crazynucfan/thread-clapclap/firmware/ThreadClapClap/ThreadClapClap.ino

#include <Arduino.h>
#include <Matter.h>
#include <sdkconfig.h>

#if !defined(CONFIG_IDF_TARGET_ESP32C6)
#error "Select XIAO_ESP32C6. This example targets the ESP32-C6 native Thread radio."
#endif
#if !CONFIG_ENABLE_MATTER_OVER_THREAD || !CONFIG_ENABLE_CHIPOBLE
#error "This example requires Matter over Thread with BLE commissioning."
#endif
#if !CONFIG_OPENTHREAD_FTD
#error "A Full Thread Device build is required for Thread router eligibility."
#endif

#include <esp_openthread.h>
#include <esp_openthread_lock.h>
#include <openthread/thread.h>
#include <openthread/thread_ftd.h>
#include <openthread/link.h>
#include <platform/CHIPDeviceLayer.h>

#include "Config.h"
#include "AnalogAudio.h"
#include "AudioCapture.h"
#include "WaveCapture.h"
#include <esp_heap_caps.h>
#include "CnnDetector.h"

MatterGenericSwitch clapSwitch;
ClapDetector detector(config::detector);
AnalogAudio audio;
AudioAnalyzer analyzer;
ImpulseClapDetector audioDetector(config::audioDetector);
#if defined(CLAP_USE_CNN) && CLAP_USE_CNN
CnnDetector cnnDetector;
#endif
uint32_t lastAudioOverflow = 0;
uint32_t lastAudioStatus = 0;
uint32_t analyzedFrames = 0;
uint32_t acceptedAudioClaps = 0;
uint32_t rejectedAudioSounds = 0;
uint32_t maxAnalysisUs = 0;
uint32_t captureSession = 0, captureRemaining = 0, captureSequence = 0, captureDropped = 0, captureClicks = 0;
bool capturePending = false;
bool diagnosticsEnabled = config::diagnosticsOnBoot;
uint32_t waveRemaining = 0, waveSession = 0, waveSequence = 0, waveDropped = 0;
WaveCaptureFrame wavePacket;
unsigned waveFill = 0;

static void abortCapture(const char *reason) {
#if defined(CLAP_USE_CNN) && CLAP_USE_CNN
  cnnDetector.reset();
#endif
  if (captureRemaining) Serial.printf("CAPTURE_ABORT %lu %s\n", static_cast<unsigned long>(captureSession), reason);
  capturePending = false;
  captureRemaining = 0;
  if (waveRemaining) {
    Serial.printf("WAVE_ABORT %lu %s\n", static_cast<unsigned long>(waveSession), reason);
    analyzer.reset();
    audioDetector.reset(0);
  }
  waveRemaining = 0;
  waveFill = 0;
}

static void captureWave(const uint16_t *samples, uint32_t count) {
  for (uint32_t i = 0; i < count && waveRemaining; ++i) {
    wavePacket.samples[waveFill++] = samples[i];
    if (waveFill != 64) continue;
    if (audio.overflows() != lastAudioOverflow) {
      abortCapture("dma_overflow");
      return;
    }
    wavePacket.session = waveSession;
    wavePacket.sequence = waveSequence;
    wavePacket.firstSample = waveSequence++ * 64;
    wavePacket.checksum = captureCrc32(&wavePacket, offsetof(WaveCaptureFrame, checksum));
    if (Serial.availableForWrite() < static_cast<int>(sizeof(wavePacket))
        || Serial.write(reinterpret_cast<const uint8_t *>(&wavePacket), sizeof(wavePacket)) != sizeof(wavePacket)) ++waveDropped;
    waveFill = 0;
    if (--waveRemaining == 0) {
      Serial.printf("WAVE_END %lu %lu %lu\n", static_cast<unsigned long>(waveSession),
                    static_cast<unsigned long>(waveSequence), static_cast<unsigned long>(waveDropped));
    }
  }
}

static void handleSerialCommands() {
  static char line[64];
  static size_t length = 0;
  static bool tooLong = false;
  for (unsigned budget = 0; budget < 64 && Serial.available(); ++budget) {
    const char c = static_cast<char>(Serial.read());
    if (c == '\r') continue;
    if (c != '\n') {
      if (length < sizeof(line) - 1) line[length++] = c;
      else tooLong = true;
      continue;
    }
    line[length] = 0;
    unsigned long session = 0, seconds = 0;
    char extra = 0;
    if (!tooLong && strcmp(line, "LOG ON") == 0) {
      diagnosticsEnabled = true;
      Serial.println("LOG ON: diagnostics enabled until reboot.");
    } else if (!tooLong && strcmp(line, "LOG OFF") == 0) {
      diagnosticsEnabled = false;
      Serial.println("LOG OFF: diagnostics disabled; detection continues.");
    } else if (!tooLong && strcmp(line, "MEMORY") == 0) {
      Serial.printf("Memory: free_8bit=%u largest_8bit=%u minimum_free_8bit=%u\n",
                    static_cast<unsigned>(heap_caps_get_free_size(MALLOC_CAP_8BIT)),
                    static_cast<unsigned>(heap_caps_get_largest_free_block(MALLOC_CAP_8BIT)),
                    static_cast<unsigned>(heap_caps_get_minimum_free_size(MALLOC_CAP_8BIT)));
#if defined(CLAP_USE_CNN) && CLAP_USE_CNN
    } else if (!tooLong && strcmp(line, "CNN STATUS") == 0) {
      cnnDetector.status(audio.overflows(),maxAnalysisUs);
#endif
    } else if (!tooLong && (strcmp(line, "CAPTURE_STOP") == 0 || strcmp(line, "WAVE_STOP") == 0)) {
      abortCapture("stopped");
      audioDetector.reset(analyzer.timeMs());
    } else if (!tooLong && sscanf(line, "WAVE_CAPTURE %lu %lu %c", &session, &seconds, &extra) == 2
               && session && seconds >= 4 && seconds <= 600 && config::useAnalogAudio) {
      abortCapture("replaced");
      waveSession = static_cast<uint32_t>(session);
      waveRemaining = static_cast<uint32_t>(seconds * 250);
      waveSequence = waveDropped = waveFill = 0;
      audioDetector.reset(analyzer.timeMs());
      Serial.printf("WAVE_BEGIN %lu %lu 16000 %lu\n", static_cast<unsigned long>(waveSession),
                    static_cast<unsigned long>(waveRemaining), static_cast<unsigned long>(CLAP_DETECTOR_BUILD_ID));
    } else if (!tooLong && sscanf(line, "CAPTURE %lu %lu %c", &session, &seconds, &extra) == 2
               && session && seconds >= 4 && seconds <= 600 && config::useAnalogAudio) {
      abortCapture("replaced");
      captureSession = static_cast<uint32_t>(session);
      captureRemaining = static_cast<uint32_t>(seconds * 125);
      captureSequence = captureDropped = captureClicks = 0;
      capturePending = true;
    } else if (length) Serial.println("CAPTURE_ERROR expected LOG ON/OFF, MEMORY, CAPTURE/WAVE_CAPTURE <id> <4..600 seconds> or CAPTURE_STOP/WAVE_STOP");
    length = 0; tooLong = false;
  }
}

// Capture both edges: even very short LOW pulses reach the detector. No logging
// or Matter calls in the ISR. Drop the whole partial gesture on queue overflow.
struct SoundEdge {
  uint32_t ms;
  bool active;
};
constexpr uint16_t edgeCapacity = 128;
volatile SoundEdge edges[edgeCapacity];
volatile uint16_t edgeHead = 0;
volatile uint16_t edgeTail = 0;
volatile bool edgeOverflow = false;
portMUX_TYPE edgeMux = portMUX_INITIALIZER_UNLOCKED;

void ARDUINO_ISR_ATTR captureSoundEdge() {
  portENTER_CRITICAL_ISR(&edgeMux);
  const uint16_t next = (edgeHead + 1) % edgeCapacity;
  if (next == edgeTail) {
    edgeOverflow = true;
  } else {
    edges[edgeHead].ms = millis();
    edges[edgeHead].active = digitalRead(config::soundPin) == LOW;
    edgeHead = next;
  }
  portEXIT_CRITICAL_ISR(&edgeMux);
}

bool routerConfigured = false;
bool resetHeld = false;
bool resetRequested = false;
uint32_t resetStarted = 0;
uint32_t detectionStarted = 0;
uint32_t lastStatus = 0;
bool lastReady = false;
uint32_t droppedBatches = 0;

static void fatal(const char *message) {
  Serial.println(message);
  while (true) {
    delay(1000);
  }
}

static const char *roleName(otDeviceRole role) {
  switch (role) {
    case OT_DEVICE_ROLE_DISABLED: return "disabled";
    case OT_DEVICE_ROLE_DETACHED: return "detached";
    case OT_DEVICE_ROLE_CHILD: return "child";
    case OT_DEVICE_ROLE_ROUTER: return "router";
    case OT_DEVICE_ROLE_LEADER: return "leader";
    default: return "unknown";
  }
}

static void updateThreadStatus() {
  // Matter owns OpenThread initialization. Do not start a second OT stack,
  // create a dataset, or force a router role: join the phone's existing network.
  if (!esp_openthread_lock_acquire(pdMS_TO_TICKS(20))) {
    return;
  }
  otInstance *instance = esp_openthread_get_instance();
  if (instance == nullptr) {
    esp_openthread_lock_release();
    return;
  }
  otError error = OT_ERROR_NONE;
  if (!routerConfigured) {
    otLinkModeConfig mode = otThreadGetLinkMode(instance);
    mode.mRxOnWhenIdle = true;
    mode.mDeviceType = true;
    mode.mNetworkData = true;
    error = otThreadSetLinkMode(instance, mode);
    if (error == OT_ERROR_NONE) {
      error = otThreadSetRouterEligible(instance, true);
    }
    routerConfigured = error == OT_ERROR_NONE;
  }
  if (!diagnosticsEnabled) {
    esp_openthread_lock_release();
    return;
  }
  const otDeviceRole role = otThreadGetDeviceRole(instance);
  const bool eligible = otThreadIsRouterEligible(instance);
  otNeighborInfoIterator iterator = OT_NEIGHBOR_INFO_ITERATOR_INIT;
  otNeighborInfo neighbor;
  unsigned neighbors = 0;
  int weakestRssi = 0;
  unsigned minQuality = 3;
  while (otThreadGetNextNeighborInfo(instance, &iterator, &neighbor) == OT_ERROR_NONE) {
    ++neighbors;
    if (neighbor.mAverageRssi < weakestRssi) weakestRssi = neighbor.mAverageRssi;
    if (neighbor.mLinkQualityIn < minQuality) minQuality = neighbor.mLinkQualityIn;
  }
  const otMacCounters *counters = otLinkGetCounters(instance);
  const uint32_t retries = counters->mTxRetry;
  const uint32_t ackRequested = counters->mTxAckRequested;
  const uint32_t acked = counters->mTxAcked;
  esp_openthread_lock_release();
  Serial.printf("Thread: role=%s router_eligible=%s config_error=%u\n",
                roleName(role), eligible ? "yes" : "no", static_cast<unsigned>(error));
  Serial.printf("Thread radio: neighbors=%u weakest_rssi_dbm=%d min_link_quality=%u tx_retries=%lu acked=%lu requested=%lu\n",
                neighbors, weakestRssi, neighbors ? minQuality : 0,
                static_cast<unsigned long>(retries), static_cast<unsigned long>(acked),
                static_cast<unsigned long>(ackRequested));
}

static void reportDoubleClap(bool ready) {
#if defined(CLAP_CNN_SHADOW) && CLAP_CNN_SHADOW
  if (diagnosticsEnabled) Serial.println("CNN shadow: double clap detected; Matter click suppressed.");
  return;
#endif
  if (!ready) {
    if (diagnosticsEnabled) Serial.println("Double clap detected; offline, event discarded.");
    return;
  }
  static uint32_t clicks = 0;
  ++clicks;
  if (diagnosticsEnabled) {
    Serial.printf("Double clap -> Matter button click (InitialPress + ShortRelease). click=%lu uptime_ms=%lu\n",
                  static_cast<unsigned long>(clicks), static_cast<unsigned long>(millis()));
  }
  clapSwitch.click();
}

static void processSound(bool ready) {
  SoundEdge batch[edgeCapacity];
  uint16_t size = 0;
  // Snapshot time and pin level with the queue, preserving timestamp order.
  portENTER_CRITICAL(&edgeMux);
  const bool overflow = edgeOverflow;
  edgeOverflow = false;
  while (edgeTail != edgeHead) {
    batch[size++] = {edges[edgeTail].ms, edges[edgeTail].active};
    edgeTail = (edgeTail + 1) % edgeCapacity;
  }
  const uint32_t now = millis();
  const bool active = digitalRead(config::soundPin) == LOW;
  portEXIT_CRITICAL(&edgeMux);

  if (overflow || now - detectionStarted < config::startupQuietMs || ready != lastReady) {
    detector.reset(now, active);
    if (overflow) {
      ++droppedBatches;
      Serial.println("Sound edge queue overflow: gesture discarded; reduce sensor gain/sensitivity.");
    }
    lastReady = ready;
    return;
  }
  const uint32_t before = detector.acceptedClaps();
  for (uint16_t i = 0; i < size; ++i) {
    if (detector.update(batch[i].ms, batch[i].active)) {
      reportDoubleClap(ready);
    }
  }
  if (detector.update(now, active)) {
    reportDoubleClap(ready);
  }
  if (diagnosticsEnabled && detector.acceptedClaps() != before) {
    Serial.printf("Clap: pending=%u accepted_total=%lu\n", detector.pendingClaps(),
                  static_cast<unsigned long>(detector.acceptedClaps()));
  }
}

static void processAudio(bool ready) {
  const uint32_t overflows = audio.overflows();
  if (overflows != lastAudioOverflow) {
    abortCapture("dma_overflow");
    lastAudioOverflow = overflows;
    analyzer.reset();
    audioDetector.reset(0);
    const esp_err_t error = audio.recover();
    if (error != ESP_OK) fatal("FATAL: could not recover ADC stream.");
    Serial.println("Audio DMA overflow: discard gesture and recalibrate; no stale event replay.");
    return;
  }
  if (ready != lastReady) {
    if (!capturePending && !waveRemaining) abortCapture("connection_changed");
    audioDetector.reset(analyzer.timeMs());
#if defined(CLAP_USE_CNN) && CLAP_USE_CNN
    cnnDetector.reset();
#endif
    lastReady = ready;
    if (diagnosticsEnabled) Serial.println("Connection changed: clear pending audio gesture and recalibrate for 2s.");
  }
  // At most 32ms of audio per loop; the Thread/Matter tasks keep getting CPU.
  bool drained = false;
  for (unsigned batch = 0; batch < 4; ++batch) {
    uint16_t samples[AnalogAudio::samplesPerRead];
    uint32_t count = 0;
    const esp_err_t error = audio.read(samples, count);
    if (error == ESP_ERR_TIMEOUT) { drained = true; break; }
    if (error == ESP_ERR_INVALID_STATE) {
      abortCapture("stream_overrun");
      analyzer.reset();
      audioDetector.reset(0);
      if (audio.recover() != ESP_OK) fatal("FATAL: ADC overrun recovery failed.");
      Serial.println("Audio stream overrun: discard gesture and recalibrate.");
      break;
    }
    if (error != ESP_OK) {
      Serial.printf("ADC read error: %s\n", esp_err_to_name(error));
      fatal("FATAL: analog sampling failed; check AOUT -> D0 and restart.");
    }
    const uint32_t startedUs = micros();
    if (waveRemaining) {
      // Raw collection needs no FFT/classifier work and must never operate
      // lamps. Resume with fresh filter history and calibration afterward.
      captureWave(samples, count);
      if (!waveRemaining) {
        analyzer.reset(); audioDetector.reset(0);
#if defined(CLAP_USE_CNN) && CLAP_USE_CNN
        cnnDetector.reset();
#endif
      }
      const uint32_t duration = micros() - startedUs;
      if (duration > maxAnalysisUs) maxAnalysisUs = duration;
      if (audio.overflows() != lastAudioOverflow) break;
      continue;
    }
    for (uint32_t i = 0; i < count; ++i) {
#if defined(CLAP_USE_CNN) && CLAP_USE_CNN
      if (!captureRemaining && !capturePending) {
        // Joining Thread takes priority over inference. A connection change
        // resets the complete stream, so the first connected 2s calibrate anew.
        if (ready) cnnDetector.push(samples[i]);
        continue;
      }
#endif
      if (!analyzer.push(samples[i])) continue;
      ++analyzedFrames;
      if (audio.overflows() != lastAudioOverflow) break;
      if (capturePending && ready) {
        capturePending = false;
        audioDetector.reset(analyzer.timeMs());
        Serial.printf("CAPTURE_BEGIN %lu %lu %lu %lu\n", static_cast<unsigned long>(captureSession),
                      static_cast<unsigned long>(captureRemaining), static_cast<unsigned long>(analyzer.timeMs()),
                      static_cast<unsigned long>(CLAP_DETECTOR_BUILD_ID));
      }
      const bool capturing = captureRemaining != 0 && !capturePending;
      const auto result = audioDetector.process(analyzer.features(), analyzer.timeMs());
      if (result.decision != ImpulseClapDetector::Decision::None && !capturing) {
        if (result.decision == ImpulseClapDetector::Decision::Accepted
            || result.decision == ImpulseClapDetector::Decision::Restarted) ++acceptedAudioClaps;
        else if (result.decision != ImpulseClapDetector::Decision::Calibrated) ++rejectedAudioSounds;
        if (diagnosticsEnabled) {
          const auto &f = audioDetector.lastCandidate();
          Serial.printf("Audio %s: rms=%.1f noise=%.1f high=%.2f flat=%.2f tone=%.2f bins=%u crest=%.2f score=%.3f spectral=%.3f flux=%.3f front=%.3f clip=%.2f start=%lu duration=%lu rise=%lu attack=%.1f pending=%u\n",
                        ImpulseClapDetector::name(result.decision), f.rms, audioDetector.noiseRms(),
                        f.highRatio, f.flatness, f.concentration, f.occupiedBins,
                        f.peak / std::fmax(f.rms, 1e-6f),
                        audioDetector.candidateScore(), audioDetector.candidateSpectralScore(),
                        audioDetector.candidateFlux(), audioDetector.candidateFrontRatio(), f.clippedFraction,
                        static_cast<unsigned long>(audioDetector.candidateStartMs()),
                        static_cast<unsigned long>(audioDetector.candidateDurationMs()),
                        static_cast<unsigned long>(audioDetector.candidateRiseMs()), audioDetector.candidateAttack(),
                        audioDetector.pendingClaps());
        }
      }
      if (capturing) {
        const auto packet = captureFrame(analyzer.features(), captureSession, captureSequence++, analyzer.timeMs(), millis());
        if (Serial.availableForWrite() < static_cast<int>(sizeof(packet))
            || Serial.write(reinterpret_cast<const uint8_t *>(&packet), sizeof(packet)) != sizeof(packet)) ++captureDropped;
        if (result.doubleClap) ++captureClicks;
        if (--captureRemaining == 0) {
          Serial.printf("CAPTURE_END %lu %lu %lu %lu\n", static_cast<unsigned long>(captureSession),
                        static_cast<unsigned long>(captureSequence), static_cast<unsigned long>(captureDropped),
                        static_cast<unsigned long>(captureClicks));
          audioDetector.reset(analyzer.timeMs());
#if defined(CLAP_USE_CNN) && CLAP_USE_CNN
          cnnDetector.reset();
#endif
        }
      } else if (result.doubleClap && !capturePending && audio.overflows() == lastAudioOverflow) reportDoubleClap(ready);
    }
    const uint32_t duration = micros() - startedUs;
    if (duration > maxAnalysisUs) maxAnalysisUs = duration;
    // If an overflow happened while processing, discard everything before more
    // samples are consumed; the recovery path above runs on the next loop.
    if (audio.overflows() != lastAudioOverflow) break;
  }
#if defined(CLAP_USE_CNN) && CLAP_USE_CNN
  if (ready && drained && !captureRemaining && !capturePending && !waveRemaining
      && audio.overflows() == lastAudioOverflow) {
    const bool clicked = cnnDetector.service(diagnosticsEnabled);
    if (clicked && audio.overflows() == lastAudioOverflow) reportDoubleClap(ready);
  }
#else
  (void)drained;
#endif
  const uint32_t now = millis();
  if (diagnosticsEnabled && !captureRemaining && !waveRemaining && now - lastAudioStatus >= 2000) {
    lastAudioStatus = now;
#if defined(CLAP_USE_CNN) && CLAP_USE_CNN
    cnnDetector.status(lastAudioOverflow,maxAnalysisUs);
#else
    const auto &f = analyzer.features();
    Serial.printf("Audio status: frames=%lu rms=%.1f noise=%.1f raw=%.0f range=%u..%u clip=%.2f accepted=%lu rejected=%lu dma_overflows=%lu max_batch_us=%lu\n",
                  static_cast<unsigned long>(analyzedFrames), f.rms, audioDetector.noiseRms(),
                  f.rawMean, f.rawMin, f.rawMax, f.clippedFraction,
                  static_cast<unsigned long>(acceptedAudioClaps), static_cast<unsigned long>(rejectedAudioSounds),
                  static_cast<unsigned long>(lastAudioOverflow), static_cast<unsigned long>(maxAnalysisUs));
#endif
  }
}

static void handleFactoryReset() {
  const uint32_t now = millis();
  if (digitalRead(config::resetButtonPin) != LOW) {
    resetHeld = false;
  } else if (!resetHeld) {
    resetHeld = true;
    resetStarted = now;
  } else if (!resetRequested && now - resetStarted >= config::factoryResetHoldMs) {
    resetRequested = true;
    Serial.println("BOOT held 5s: erasing Matter fabrics and Thread credentials; restarting.");
    Matter.decommission();
  }
}

void setup() {
  Serial.setTxBufferSize(4096); // native USB waveform bursts; never wait for a reader
  Serial.begin(115200);
  Serial.setTxTimeoutMs(0); // logging must never stall audio when USB isn't read
  delay(500);  // bounded: standalone USB power must work without a serial host
  pinMode(config::soundPin, INPUT_PULLUP);
  pinMode(config::resetButtonPin, INPUT_PULLUP);
  Serial.printf("\nThread ClapClap: double-clap Matter button, XIAO ESP32-C6 / sound GPIO%u.\n", config::soundPin);
  Serial.printf("Diagnostics %s. Send LOG ON / LOG OFF with a newline over USB.\n",
                diagnosticsEnabled ? "on" : "off");

  if (!Matter.selectNetwork(MATTER_NETWORK_THREAD)) {
    fatal("FATAL: Matter Thread transport selection failed.");
  }
  if (!clapSwitch.begin()) {
    fatal("FATAL: could not create the Matter Generic Switch endpoint.");
  }
  Matter.setDeviceName("Thread ClapClap");
  Matter.setProductName("Thread ClapClap");
  Matter.begin();
  const String pairingCode = Matter.getManualPairingCode();
  if (pairingCode.isEmpty()) {
    fatal("FATAL: Matter startup failed; inspect the preceding SDK log.");
  }
  Serial.printf("Generic Switch endpoint: %u\n", clapSwitch.getEndPointId());
  if (!Matter.isDeviceCommissioned()) {
    Serial.println("Pair with Home Assistant Companion -> Add Matter device.");
    Serial.println("Manual pairing code: " + pairingCode);
    Serial.println("QR code URL: " + Matter.getOnboardingQRCodeUrl());
  }
  updateThreadStatus();
  detectionStarted = millis();
  if (config::useAnalogAudio) {
#if defined(CLAP_USE_CNN) && CLAP_USE_CNN
    if (!cnnDetector.begin()) fatal("FATAL: CNN allocation or model/frontend self-test failed; no actions enabled.");
#endif
    const esp_err_t error = audio.begin(config::audioPin, AudioAnalyzer::sampleRate);
    if (error != ESP_OK) {
      Serial.printf("ADC start error: %s\n", esp_err_to_name(error));
      fatal("FATAL: could not start analog audio sampling.");
    }
    analyzer.reset();
    audioDetector.reset(0);
#if defined(CLAP_USE_CNN) && CLAP_USE_CNN
    cnnDetector.reset();
    Serial.printf("CNN mode: AOUT -> GPIO%u, 16kHz -> 8kHz, event-triggered INT8 model. Keep quiet for 2s.\n", config::audioPin);
#else
    Serial.printf("Analog burst-score mode: AOUT -> GPIO%u, 16kHz / 256 samples / 50%% overlap. Keep quiet for 2s.\n", config::audioPin);
#endif
  } else {
    detector.reset(detectionStarted, digitalRead(config::soundPin) == LOW);
    attachInterrupt(digitalPinToInterrupt(config::soundPin), captureSoundEdge, CHANGE);
    Serial.println("Digital mode: allow 1.5s to settle. DOUT only; no FFT filtering.");
  }
  Serial.println("Clap twice, 160-599ms apart. Single claps do nothing.");
}

void loop() {
  // Protect Matter's state reads against the CHIP task. Sound detection keeps
  // ADC acquisition continues offline; CNN inference starts after Thread joins.
  chip::DeviceLayer::PlatformMgr().LockChipStack();
  const bool commissioned = Matter.isDeviceCommissioned();
  const bool ready = commissioned && Matter.isThreadConnected();
  chip::DeviceLayer::PlatformMgr().UnlockChipStack();
  handleSerialCommands();
  if (config::useAnalogAudio) processAudio(ready);
  else processSound(ready);
  handleFactoryReset();
  const uint32_t now = millis();
  if (!captureRemaining && !waveRemaining && now - lastStatus >= 10000) {
    lastStatus = now;
    if (diagnosticsEnabled) {
      Serial.printf("Matter: commissioned=%s connected=%s DOUT=%s overflows=%lu\n",
                    commissioned ? "yes" : "no", ready ? "yes" : "no",
                    digitalRead(config::soundPin) == LOW ? "LOW" : "HIGH",
                    static_cast<unsigned long>(droppedBatches));
    }
    updateThreadStatus();
  }
  delay(1);
}
