crazynucfan/thread-clapclap/tools/project.py

#!/usr/bin/env python3
"""Build, test and flash Thread ClapClap using the pinned Arduino ESP32 core."""

import argparse
import hashlib
import json
import os
from pathlib import Path
import shutil
import subprocess
import sys

ROOT = Path(__file__).resolve().parents[1]
CORE = "3.3.12"
FQBN = "esp32:esp32:XIAO_ESP32C6:PartitionScheme=huge_app,CDCOnBoot=cdc"
INDEX = "https://espressif.github.io/arduino-esp32/package_esp32_index.json"
SKETCH = ROOT / "firmware" / "ThreadClapClap"
OUTPUT = ROOT / ".build" / "firmware"


def run(command):
    print("+", " ".join(map(str, command)), flush=True)
    subprocess.run(list(map(str, command)), cwd=ROOT, check=True)


def main():
    parser = argparse.ArgumentParser(description=__doc__)
    parser.add_argument("--cli", default=os.environ.get("ARDUINO_CLI", "arduino-cli"))
    parser.add_argument("--cli-config", type=Path, help="optional isolated Arduino CLI configuration")
    parser.add_argument("--build-dir", type=Path, default=ROOT / ".build" / "arduino")
    sub = parser.add_subparsers(dest="command", required=True)
    sub.add_parser("test", help="run hardware-independent C++ detector tests")
    sub.add_parser("setup", help=f"install Arduino ESP32 {CORE} (downloads the toolchain)")
    build = sub.add_parser("build", help="compile firmware")
    build.add_argument("--cnn-assets", type=Path, help="private assets generated by cnn_deploy.py; enables CNN inference")
    build.add_argument("--cnn-shadow", action='store_true', help="benchmark a CNN without sending Matter clicks")
    build.add_argument("--pair-policy", choices=('immediate','exact-two'), default='immediate', help="CNN first-pair response, or legacy wait-and-cancel-third behavior")
    build.add_argument("--output-dir", type=Path, default=OUTPUT, help="final firmware directory; use a separate private directory for experiments")
    sub.add_parser("ports", help="list connected boards")
    flash = sub.add_parser("flash", help="upload a previously built firmware")
    flash.add_argument("--port", required=True, help="e.g. COM7 or /dev/ttyACM0")
    flash.add_argument("--input-dir", type=Path, default=OUTPUT, help="verified firmware directory; can point to a saved rollback")
    monitor = sub.add_parser("monitor", help="open the 115200 baud serial console")
    monitor.add_argument("--port", required=True)
    args = parser.parse_args()

    if args.command == "test":
        compiler = os.environ.get("CXX", "g++")
        if not shutil.which(compiler):
            parser.error(f"{compiler} not found; install a C++ compiler or set CXX=clang++")
        for source in sorted((ROOT / "tests").glob("*_test.cpp")):
            binary = ROOT / ".build" / source.stem
            binary.parent.mkdir(parents=True, exist_ok=True)
            run([compiler, "-std=c++17", "-Wall", "-Wextra", "-Werror", "-pedantic",
                 source, "-o", binary])
            run([binary])
        run([sys.executable, "-m", "unittest", "discover", "-s", "tests", "-p", "*_test.py"])
        return

    if not shutil.which(args.cli):
        parser.error("Arduino CLI not found; install it from https://arduino.github.io/arduino-cli/")
    cli = [args.cli]
    if args.cli_config:
        cli += ["--config-file", str(args.cli_config.resolve())]

    if args.command == "setup":
        run(cli + ["core", "update-index", "--additional-urls", INDEX])
        run(cli + ["core", "install", f"esp32:esp32@{CORE}", "--additional-urls", INDEX])
    elif args.command == "ports":
        run(cli + ["board", "list"])
    elif args.command == "monitor":
        run(cli + ["monitor", "--port", args.port, "--config", "baudrate=115200"])
    else:
        installed = json.loads(subprocess.check_output(cli + ["core", "list", "--format", "json"], text=True))
        platforms = installed.get("platforms", [])
        if not any(p.get("id") == "esp32:esp32" and p.get("installed_version") == CORE for p in platforms):
            parser.error(f"Arduino ESP32 {CORE} is required; run tools/project.py setup first")
        if args.command == "build":
            output = args.output_dir.resolve()
            if args.cnn_shadow and not args.cnn_assets:
                parser.error('--cnn-shadow requires --cnn-assets')
            digest = hashlib.sha256()
            sketch = SKETCH
            cnn_manifest = None
            for source in sorted(SKETCH.iterdir()):
                if source.suffix in ('.h', '.cpp', '.ino'):
                    digest.update(source.name.encode()); digest.update(source.read_bytes())
            flags = ""
            if args.cnn_assets:
                assets = args.cnn_assets.resolve()
                cnn_manifest = json.loads((assets / 'deployment.json').read_text())
                sketch = ROOT / '.build' / 'cnn-sketch' / 'ThreadClapClap'
                sketch.mkdir(parents=True, exist_ok=True)
                for source in SKETCH.iterdir():
                    if source.suffix in ('.h', '.cpp', '.ino'):
                        shutil.copy2(source, sketch / source.name)
                for name in ('ClapModel.local.h', 'CnnTables.local.h'):
                    digest.update((assets / name).read_bytes())
                    shutil.copy2(assets / name, sketch / name)
                benchmark_header = assets / 'CnnBenchmark.local.h'
                if benchmark_header.exists():
                    if not args.cnn_shadow:
                        parser.error('benchmark model banks require --cnn-shadow')
                    digest.update(benchmark_header.read_bytes())
                    shutil.copy2(benchmark_header, sketch / benchmark_header.name)
                else:
                    (sketch / 'CnnBenchmark.local.h').unlink(missing_ok=True)
                flags = " -DCLAP_USE_CNN=1"
                flags += " -DCLAP_CNN_IMMEDIATE_PAIR=" + ('1' if args.pair_policy=='immediate' else '0')
                if args.cnn_shadow:
                    flags += " -DCLAP_CNN_SHADOW=1"
            # Feature capture still runs the DSP detector even in a CNN build;
            # preserve its existing replay fingerprint protocol.
            detector_digest = hashlib.sha256()
            for name in ("ImpulseClapDetector.h", "Config.h", "WaveCapture.h"):
                detector_digest.update((SKETCH / name).read_bytes())
            detector_id = int(detector_digest.hexdigest()[:8], 16)
            run(cli + ["compile", "--fqbn", FQBN,
                       "--build-property", f"compiler.cpp.extra_flags=-DCLAP_DETECTOR_BUILD_ID={detector_id}u{flags}",
                       "--build-path", args.build_dir.resolve(),
                       "--output-dir", output, sketch])
            (output / 'build-manifest.json').write_text(json.dumps({'schema': 1, 'detector_id': detector_id,
                'source_sha256': digest.hexdigest(), 'cnn': cnn_manifest, 'cnn_shadow': args.cnn_shadow,
                'pair_policy': args.pair_policy if args.cnn_assets else None,
                'firmware_sha256': hashlib.sha256((output / 'ThreadClapClap.ino.bin').read_bytes()).hexdigest()}, indent=2)+'\n')
        elif args.command == "flash":
            firmware = args.input_dir.resolve()
            if not (firmware / "ThreadClapClap.ino.bin").is_file():
                parser.error("no firmware found; run tools/project.py build first")
            manifest = firmware / 'build-manifest.json'
            if manifest.exists():
                expected = json.loads(manifest.read_text())['firmware_sha256']
                if hashlib.sha256((firmware / 'ThreadClapClap.ino.bin').read_bytes()).hexdigest() != expected:
                    parser.error("firmware differs from its build manifest; rebuild before flashing")
            run(cli + ["upload", "--fqbn", FQBN, "--port", args.port, "--input-dir", firmware, SKETCH])


if __name__ == "__main__":
    try:
        main()
    except subprocess.CalledProcessError as error:
        sys.exit(error.returncode)
    except KeyboardInterrupt:
        sys.exit(130)
