crazynucfan/thread-clapclap/tools/cnn_gesture_replay.cpp

#include <cstdio>
#include <cstdint>
#include <cstdlib>
#include <cstring>
#include "../firmware/ThreadClapClap/CnnGesture.h"
int main(int argc,char **argv) {
  if(argc!=2 && argc!=3)return 2;
  const char *policy=argc==3?argv[2]:"exact-two";
  if(std::strcmp(policy,"immediate") && std::strcmp(policy,"exact-two"))return 2;
  CnnGesture rule(std::strtof(argv[1],nullptr),std::strcmp(policy,"immediate")==0?CnnGesture::Policy::Immediate:CnnGesture::Policy::ExactTwo);
  unsigned actions=0;uint64_t onset=0,last=0;float score;uint8_t top;double strength;
  while(std::fread(&onset,sizeof(onset),1,stdin)==1) {
    if(std::fread(&score,sizeof(score),1,stdin)!=1 || std::fread(&top,sizeof(top),1,stdin)!=1
        || std::fread(&strength,sizeof(strength),1,stdin)!=1) return 2;
    rule.candidate(onset,score,top!=0,strength);actions+=rule.advance(onset);last=onset;
  }
  actions+=rule.advance(last+10000);std::printf("%u\n",actions);return 0;
}
