crazynucfan/thread-clapclap/(commit log)

2026-10-21 Add double-clap Matter-over-Thread example for XIAO ESP32-C6
2026-10-21 Record successful Thread commissioning and double-clap recognition
2026-10-21 Confirm automatic Thread router promotion on hardware
2026-10-21 Add fixed-point FFT clap filtering and generic lamp automation examples
    [AnalogAudio.cpp, AnalogAudio.h, AudioClapDetector.h, AudioFeatures.h, Config.h, ThreadClapClap.ino]
2026-10-21 Preserve clap pairs across unrelated noise and add delivery diagnostics
    [AudioClapDetector.h, AudioFeatures.h, ThreadClapClap.ino]
2026-10-24 Select CNN cutoff using validation double-clap errors
    [cnn_lab.py]
2026-10-24 Improve existing-sample CNN recognition and attack timing
